LIUYIXIEYANG/CH32V307-Dual-brushless-motor-drive/PCB_Project(V1.1)/单车驱动BOM.xlsx

Comment | Designator | Footprint | Quantity
0.1uF | C1, C5, C6, C11, C12, C22, C25, C26, C27, C28, C32, C37, C39, C41, C52, C54, C56, C63, C68, C73, C78, C79, C80, C84, C85 | C0603_NS | 25
220uF/16V | C2, C3 | CT 2.5*6.3*7 - R | 2 | https://item.szlcsc.com/123510.html
10uF/25V | C4, C10, C20, C21, C24, C60 | C0603_NS | 6
22uF/25V | C7, C8, C13, C14, C15, C16 | C0805_NS | 6
NC | C9 | C0603_NS | 1
1uF | C17, C18, C19, C30 | C0603_NS | 4
22pF | C23, C29 | C0603_NS | 2
10nF | C31 | C0603_NS | 1
470nF | C33, C34, C35, C48, C49, C50 | C0603_NS | 6
10uF/25V | C36, C38, C40, C42, C43, C44, C45, C46, C47, C51, C53, C55, C57, C58, C59, C61, C62 | C0603_NS | 17
100pF | C64, C65, C69, C70, C74, C75 | C0603_NS | 6
1nF | C66, C67, C71, C72, C76, C77, C81, C82, C83, C86, C87, C88 | C0603_NS | 12
SMBJ18CA | D1 | SMB | 1 | https://item.szlcsc.com/84491.html
B5819W | D2 | SOD-123 | 1 | https://item.taobao.com/item.htm?spm=a1z10.3-c-s.w4002-24706531953.18.49736a4bXCLATq&id=578556528655
LED | D3, D4, D5 | LED0603_NS | 3
PESD1CAN | D6 | SOT23-3N | 1 | https://item.taobao.com/item.htm?spm=a1z10.3-c-s.w4002-24706531953.10.3d946a4bvhPwcH&id=581111679208
10A/32V | F1 | FU 1206 | 1 | 贴片熔断保险丝 1206 1A/2A/3/4/5/7/10A/15A/20A 32V/63/72/125V-淘宝网 (taobao.com) (https://item.taobao.com/item.htm?spm=a230r.1.14.3.70f112a8YnFDwl&id=574527944611&ns=1&abbucket=12) |  | 1206贴片熔断保险丝0.5A/1234A5A7A10A12A15A20A25A30A 24V32V63V-淘宝网 (taobao.com) (https://item.taobao.com/item.htm?spm=a230r.1.14.9.70f112a8YnFDwl&id=623390103028&ns=1&abbucket=12)
600Ω,500mA | FB1 | FB0603_NS | 1 | https://item.szlcsc.com/20038.html
SS-12D10L5 | K1 | SS-12D10 | 1 | https://item.szlcsc.com/300104.html
4.7uH | L1 | L-SMD-0630 | 1 | https://item.szlcsc.com/397799.html
MSD7342-223 | L2 | MSD7342 | 1 | https://item.taobao.com/item.htm?spm=a1z10.3-c-s.w4002-24391130176.33.72fbd7598o98C6&id=644408858473 |  |  | 22UH
HDR-1X3 | P1, P6 | HDR2.54-WI-3P | 2 | https://item.taobao.com/item.htm?spm=a1z10.5-c-s.w4002-24706531925.45.1a03173e28t522&id=570974088458
GH1.25-4P | P2 | A1257WR-S-4P | 1 | https://item.szlcsc.com/225410.html | https://item.taobao.com/item.htm?spm=a1z0d.6639537/tb.1997196601.232.55f97484m3fdcZ&id=622151561707
GH1.25-2P | P3 | A1257WR-S-2P | 1 | https://item.szlcsc.com/225408.html | GH1.25 2P/3/4/5/6-12P 15C单/双头1.25mm间距电子线带锁扣端子线-淘宝网 (taobao.com) (https://item.taobao.com/item.htm?spm=a1z0d.6639537/tb.1997196601.144.55f97484m3fdcZ&id=620275448420)
GH1.25-6P | P4, P5 | A1257WR-S-6P | 2 | https://item.szlcsc.com/225412.html
VS3508AE | Q1, Q2 | PowerPAK1212-8 | 2 | https://item.szlcsc.com/423219.html
AON7934 | Q3, Q4, Q5, Q6, Q7, Q8 | POWERPAIR_3X3 | 6 | https://item.szlcsc.com/494116.html
10K | R1, R13, R14 | R0603_NS | 3
100K | R2, R5 | R0603_NS | 2
100K/1% | R3, R52, R60 | R0603_NS | 3
11K/1% | R4 | R0603_NS | 1
1K | R6, R15, R16, R17 | R0603_NS | 4
10.5K/1% | R7 | R0603_NS | 1
2K/1% | R8 | R0603_NS | 1
100R | R9, R18, R19, R20, R21, R22, R23, R33, R34, R35, R36, R37, R38, R39, R49, R56, R57, R70, R71, R84, R85, R93, R94, R98, R99, R100, R104, R105, R106, R107 | R0603_NS | 30
4.12K/1% | R10 | R0603_NS | 1
12.4K/1% | R11 | R0603_NS | 1
1M | R12 | R0603_NS | 1
4R7 | R24, R25, R26, R27, R28, R29, R40, R41, R42, R43, R44, R45 | R0603_NS | 12
5mΩ/1% | R30, R31, R32, R46, R47, R48 | R1206_NS | 6 | https://item.szlcsc.com/470067.html
1K/1% | R50, R51, R58, R59 | R0603_NS | 4
1K/0.1% | R53, R54, R61, R62, R64, R65, R67, R68, R72, R73, R75, R76, R78, R79, R81, R82, R86, R87, R89, R90 | R0603_NS | 20
100K/0.1% | R55, R63, R66, R69, R74, R77, R80, R83, R88, R91 | R0603_NS | 10
120R | R92 | R0603_NS | 1
4.7K | R95, R96, R97, R101, R102, R103 | R0603_NS | 6
TS-1101-C-R | S1, S2 | TS-1101 | 2 | https://item.taobao.com/item.htm?spm=a1z10.5-c-s.w4002-24706531925.44.170040e6u5CuXK&id=556985020016
SY8105IADC | U1 | SOT23-6N | 1 | https://item.szlcsc.com/3408748.html
JW5026 | U2 | SOT23-6N | 1 | https://item.taobao.com/item.htm?id=680449503459&ns=1&abbucket=12 (https://item.taobao.com/item.htm?spm=a230r.1.14.3.2a21407aBVZD0H&id=680449503459&ns=1&abbucket=12)
RT9193 | U3 | SOT23-5N | 1 | https://item.taobao.com/item.htm?spm=a1z10.3-c-s.w4002-24706531953.10.63116a4bdsNMNh&id=522574021262
TLV431A | U4 | SOT23-3N | 1 | https://item.szlcsc.com/92264.html
CH32V307RCT6 | U5 | LQFP64_N | 1 | https://item.szlcsc.com/3443981.html
DGD05473FN-7 | U6, U7, U8, U9, U10, U11 | W-DFN3030-10_DGD05473 | 6 | https://item.szlcsc.com/203239.html
RS8552XM | U12, U13, U14 | TSSOP8_N | 3 | https://item.szlcsc.com/236482.html
TJA1050 | U15 | SOP8_N | 1 | https://item.taobao.com/item.htm?spm=a1z10.3-c-s.w4002-24706531953.9.284e6a4bbopgaC&id=522573702724
8MHz | Y1 | SMD-3225-4P | 1 | https://item.taobao.com/item.htm?spm=a1z10.3-c-s.w4002-24706531953.10.33e26a4bPSt3Qt&id=624959605211
