LIUYIXIEYANG/CH32V307-Dual-brushless-motor-drive/PCB_Project(V1.1)/单车驱动_SCH.pdf

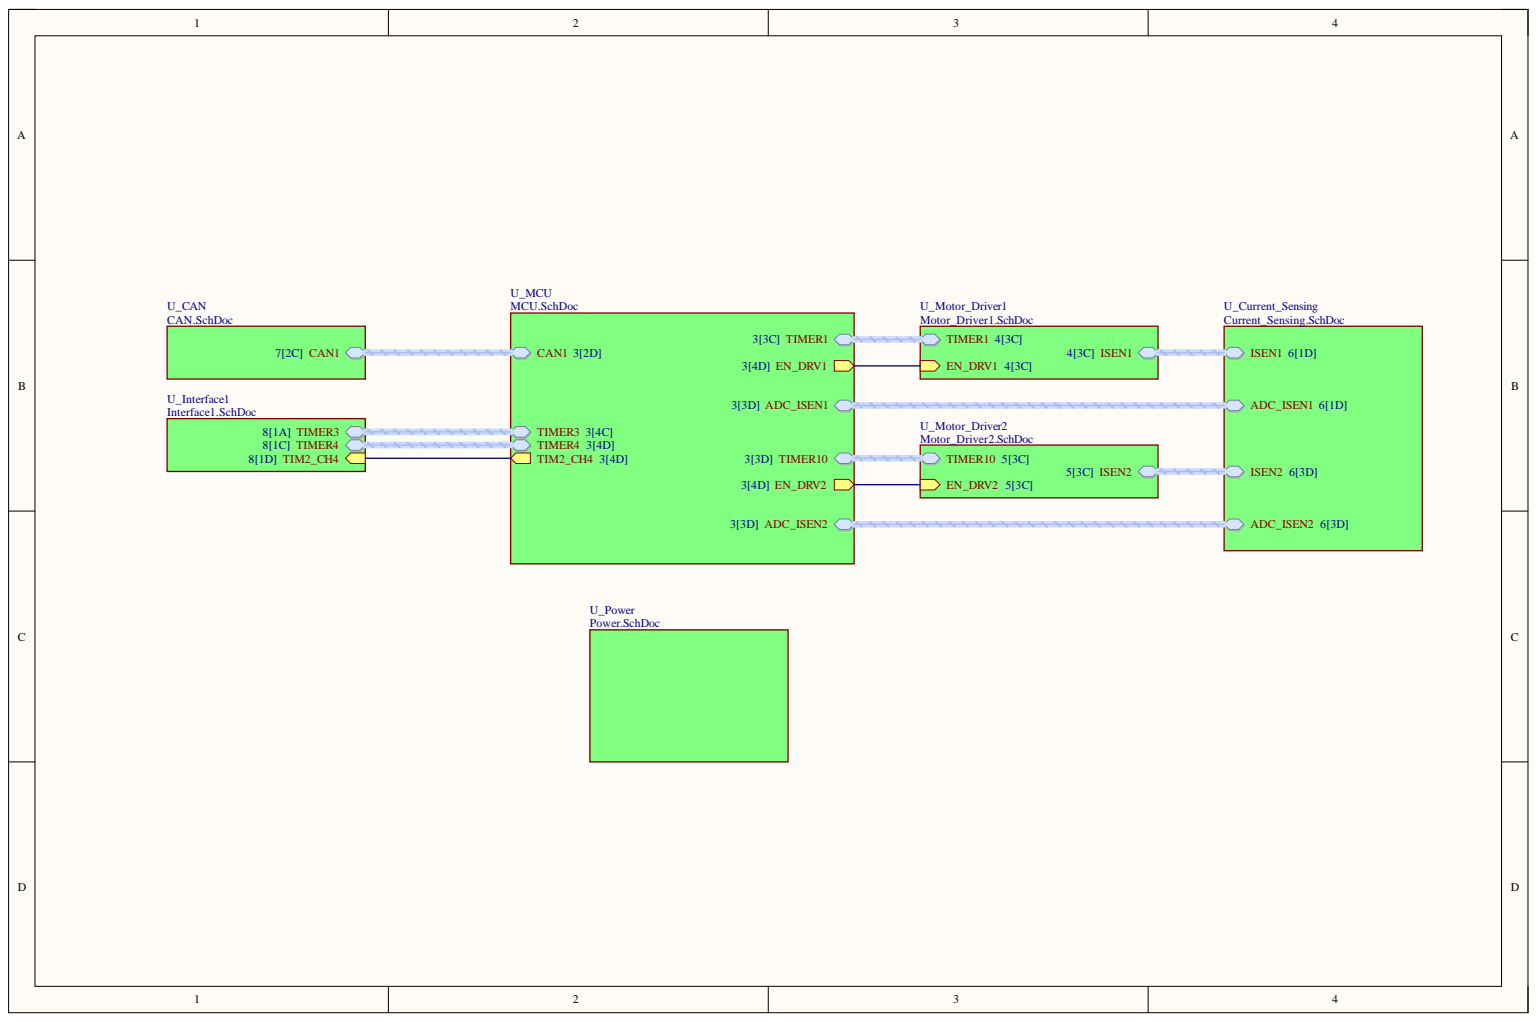
[picture p1: page 1]

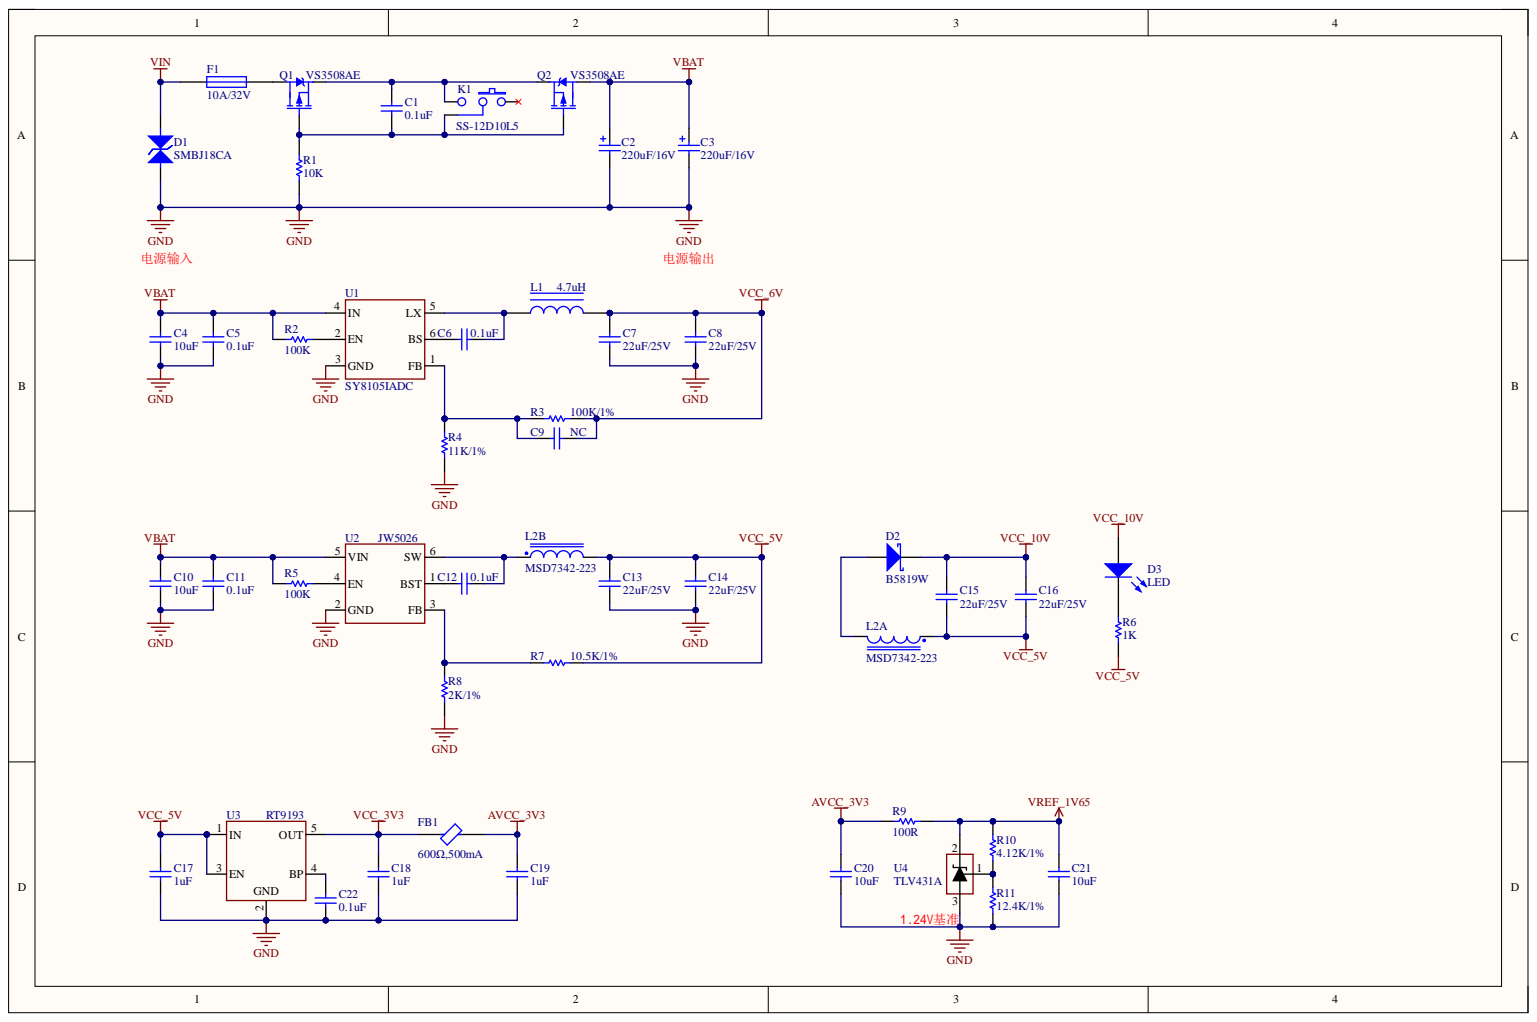
[picture p2: page 2]

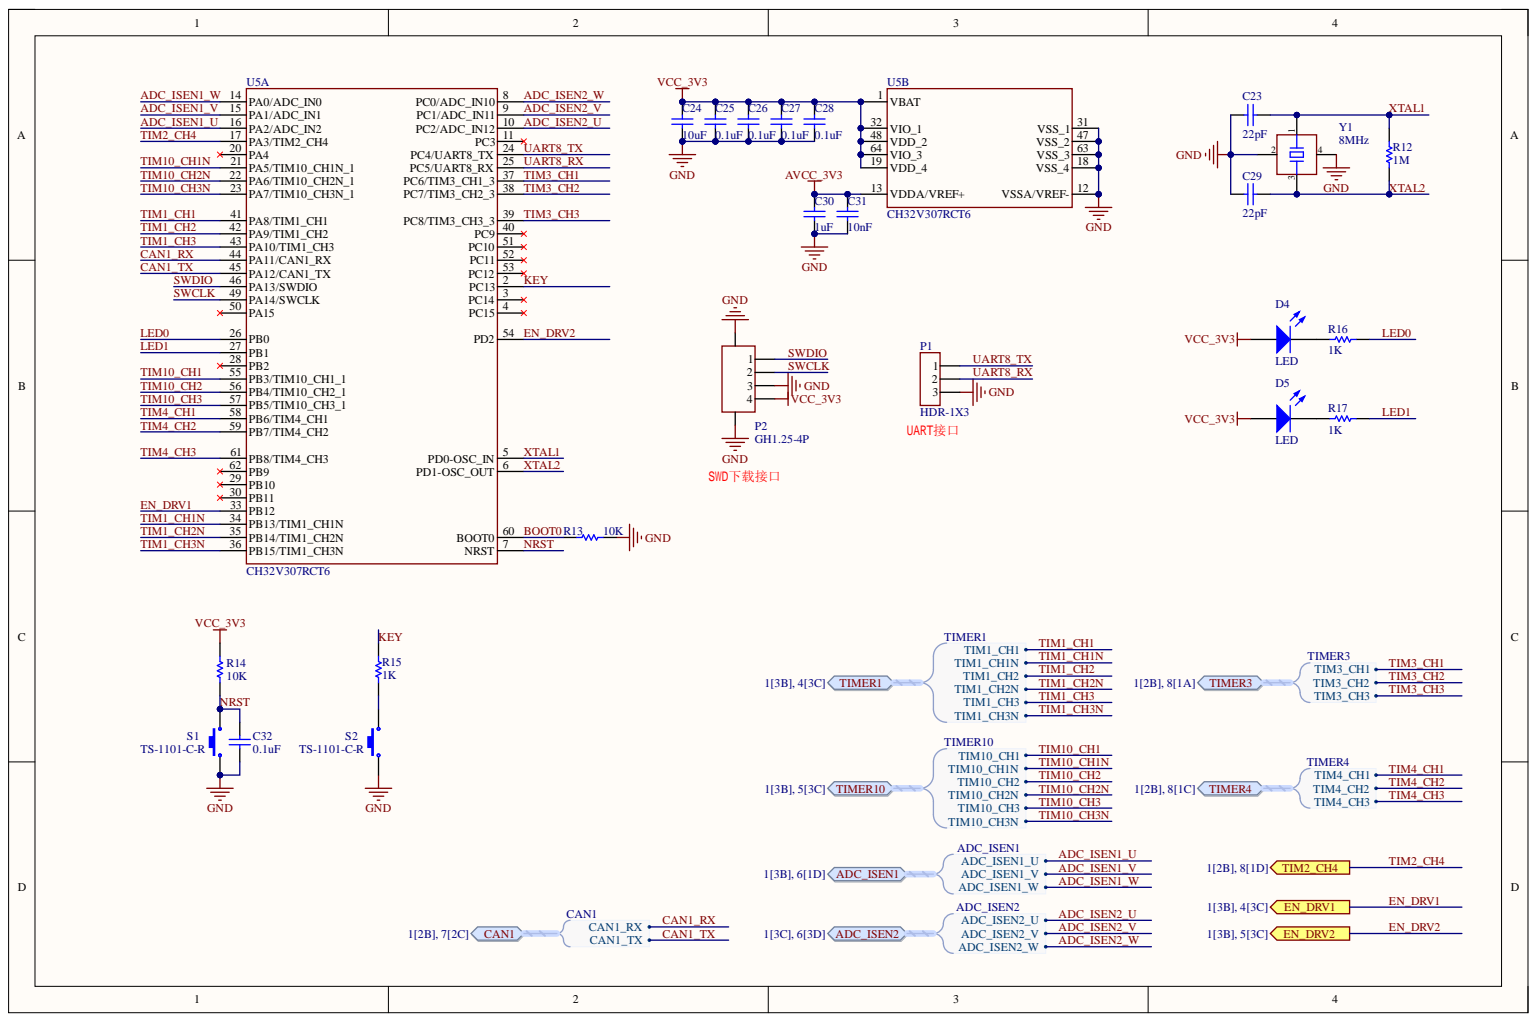
[picture p3: page 3]

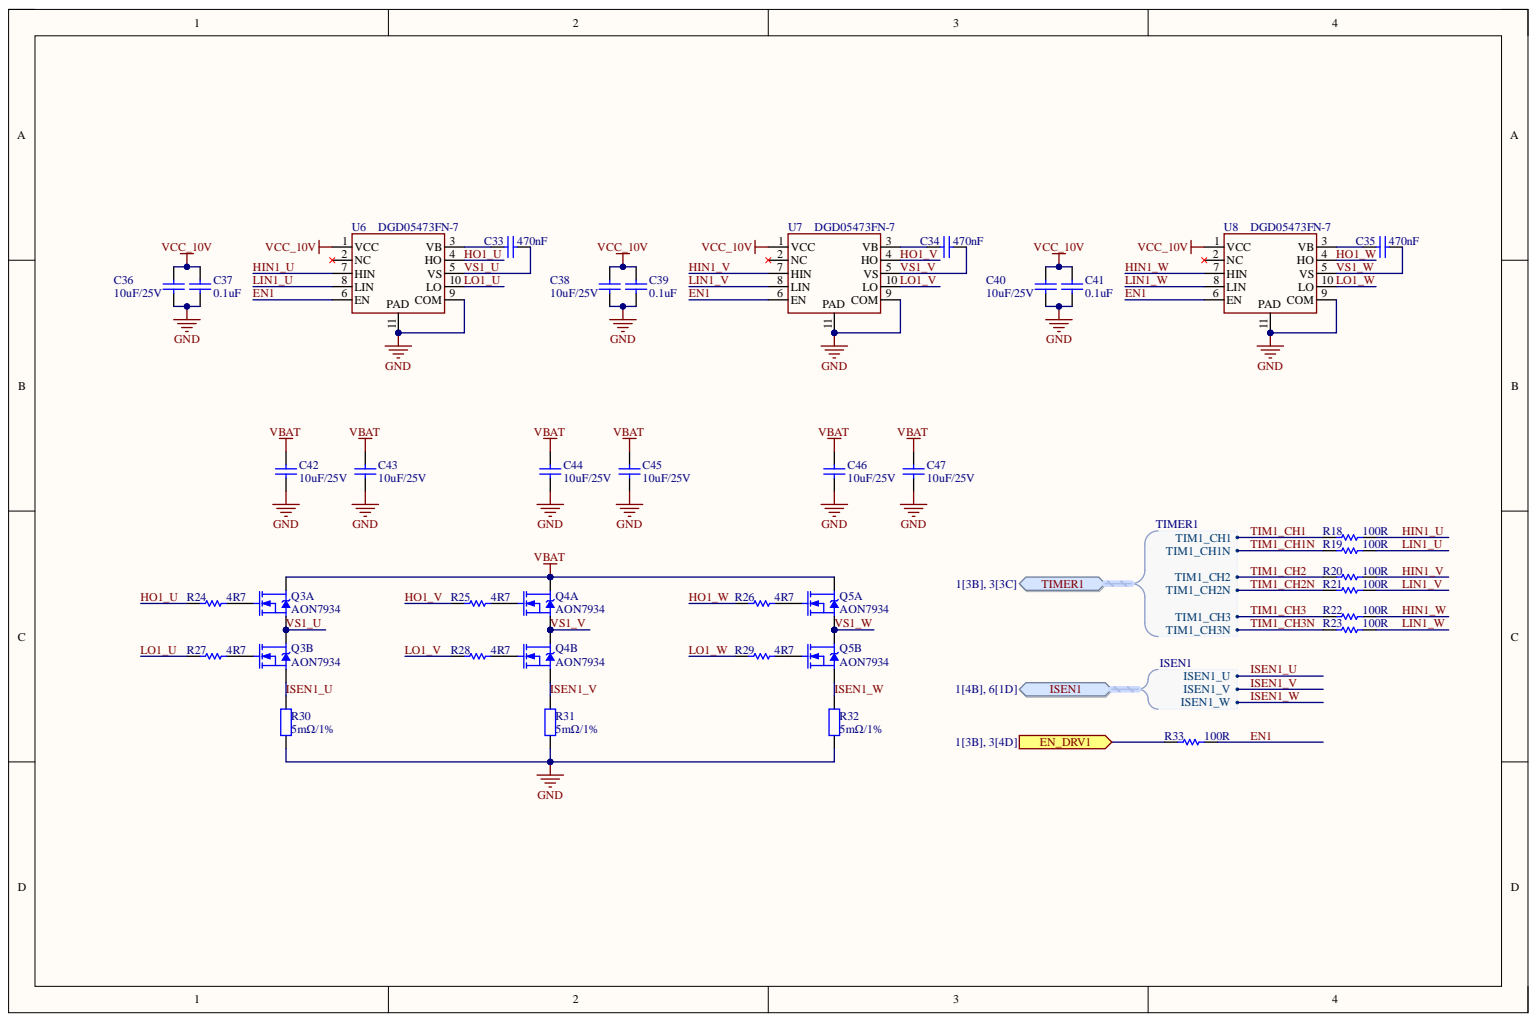
[picture p4: page 4]

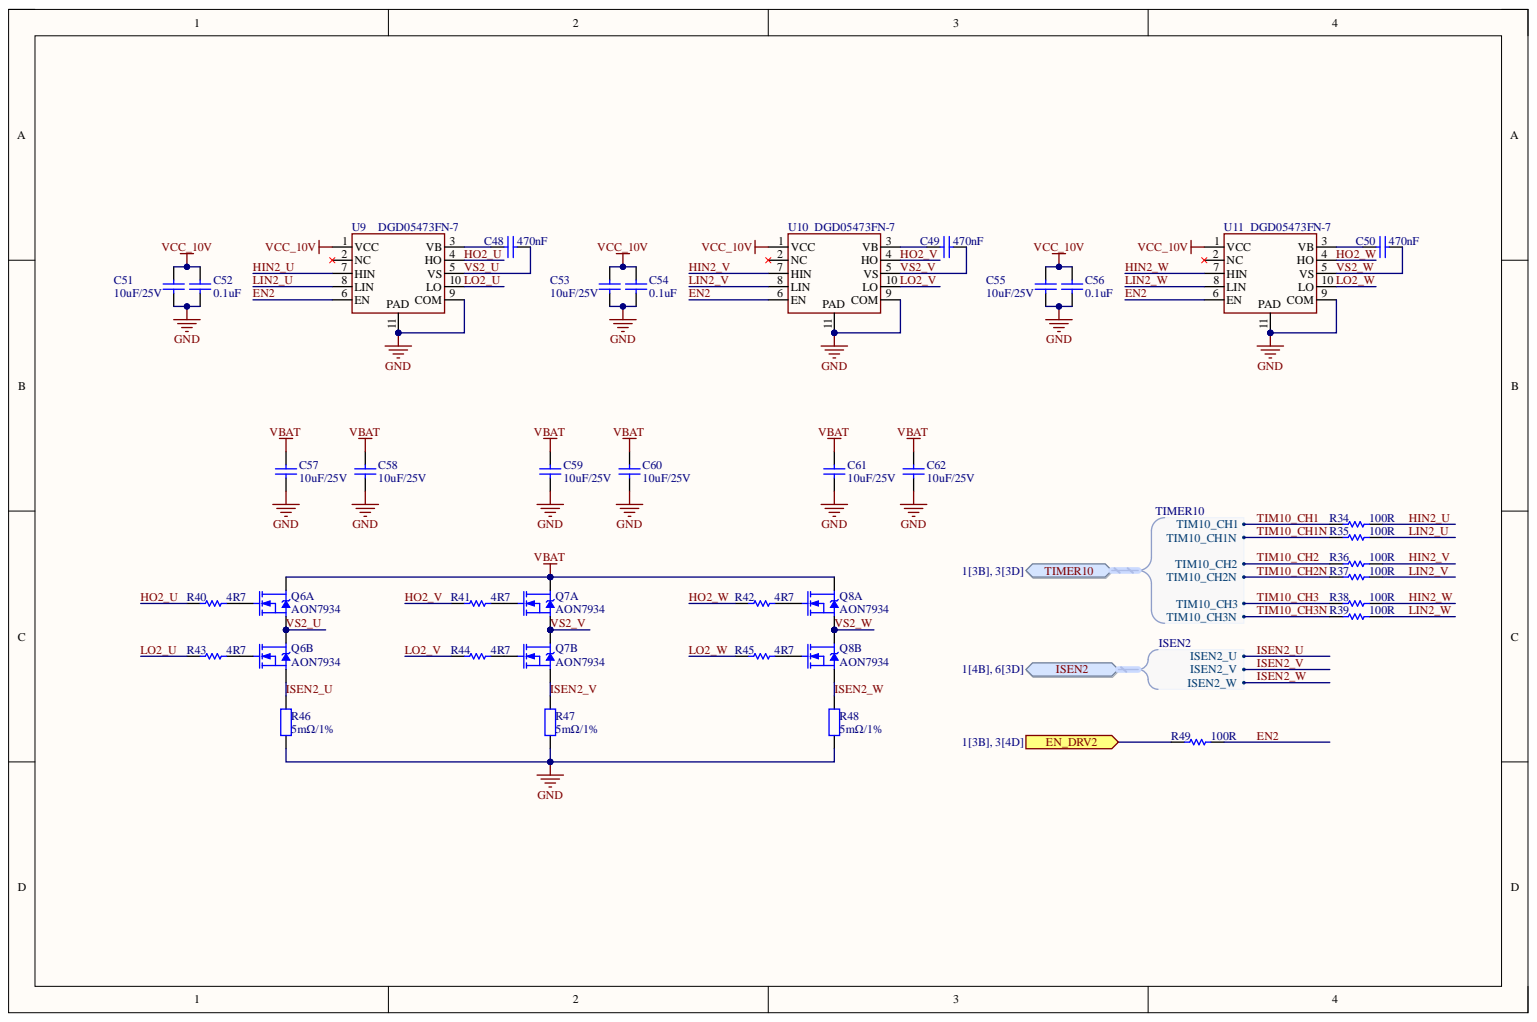
[picture p5: page 5]

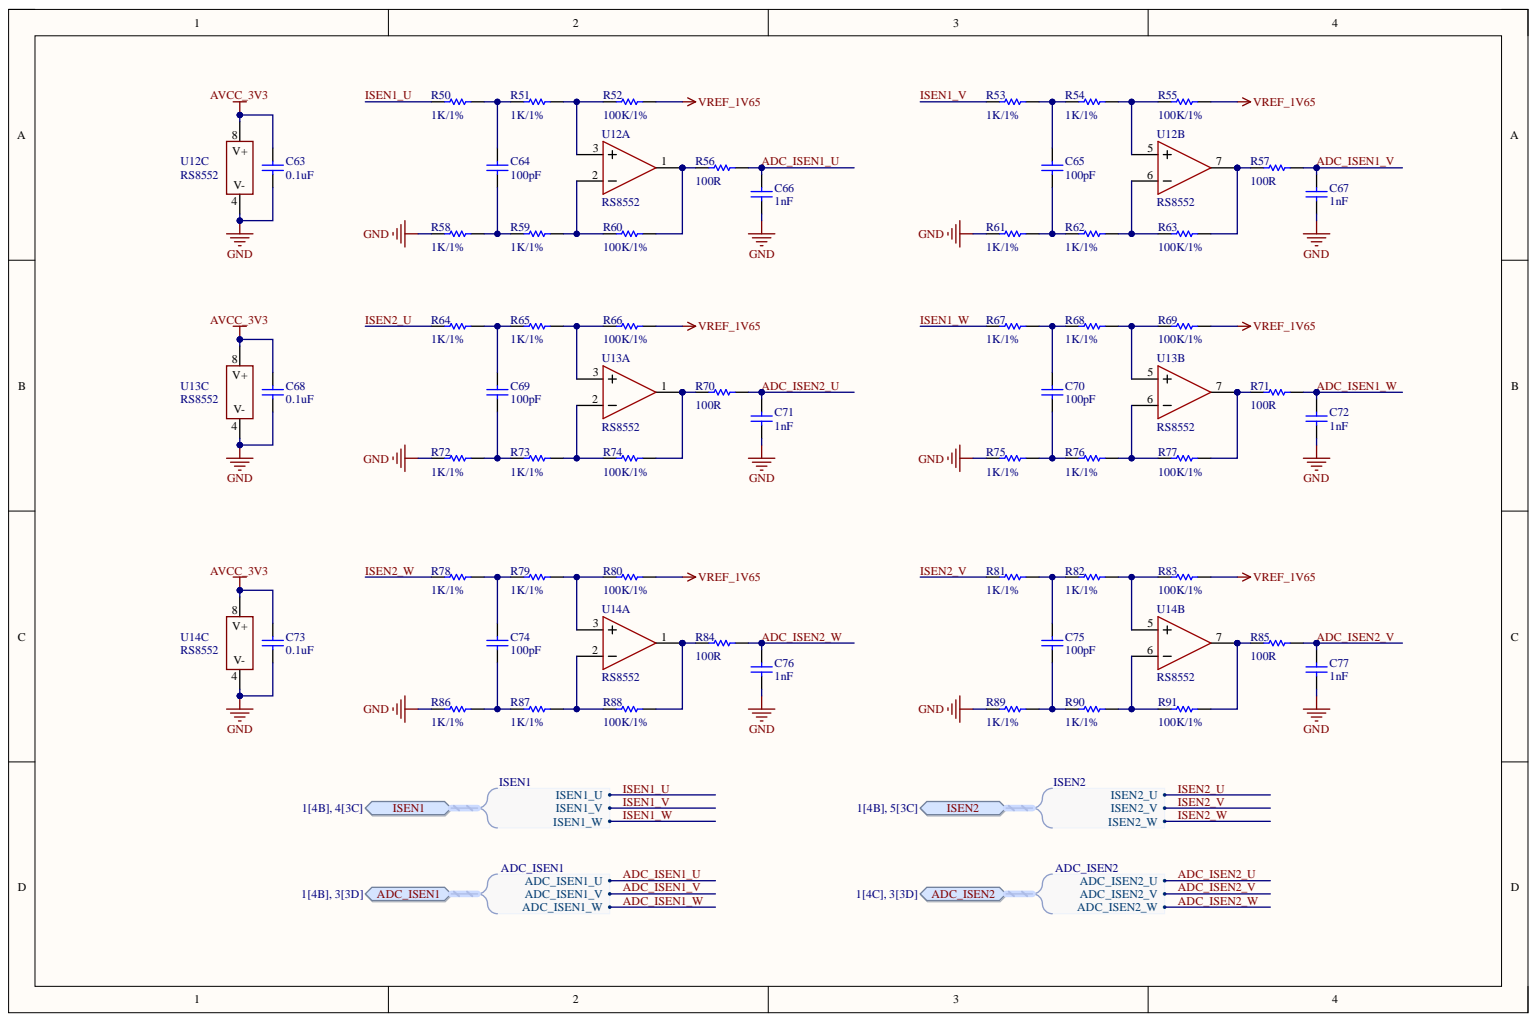
[picture p6: page 6]

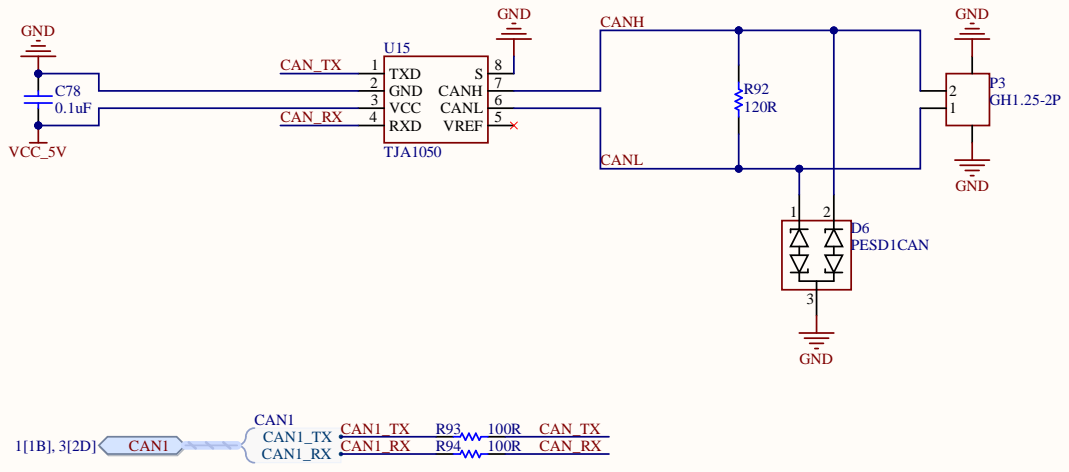
[picture p7: page 7]

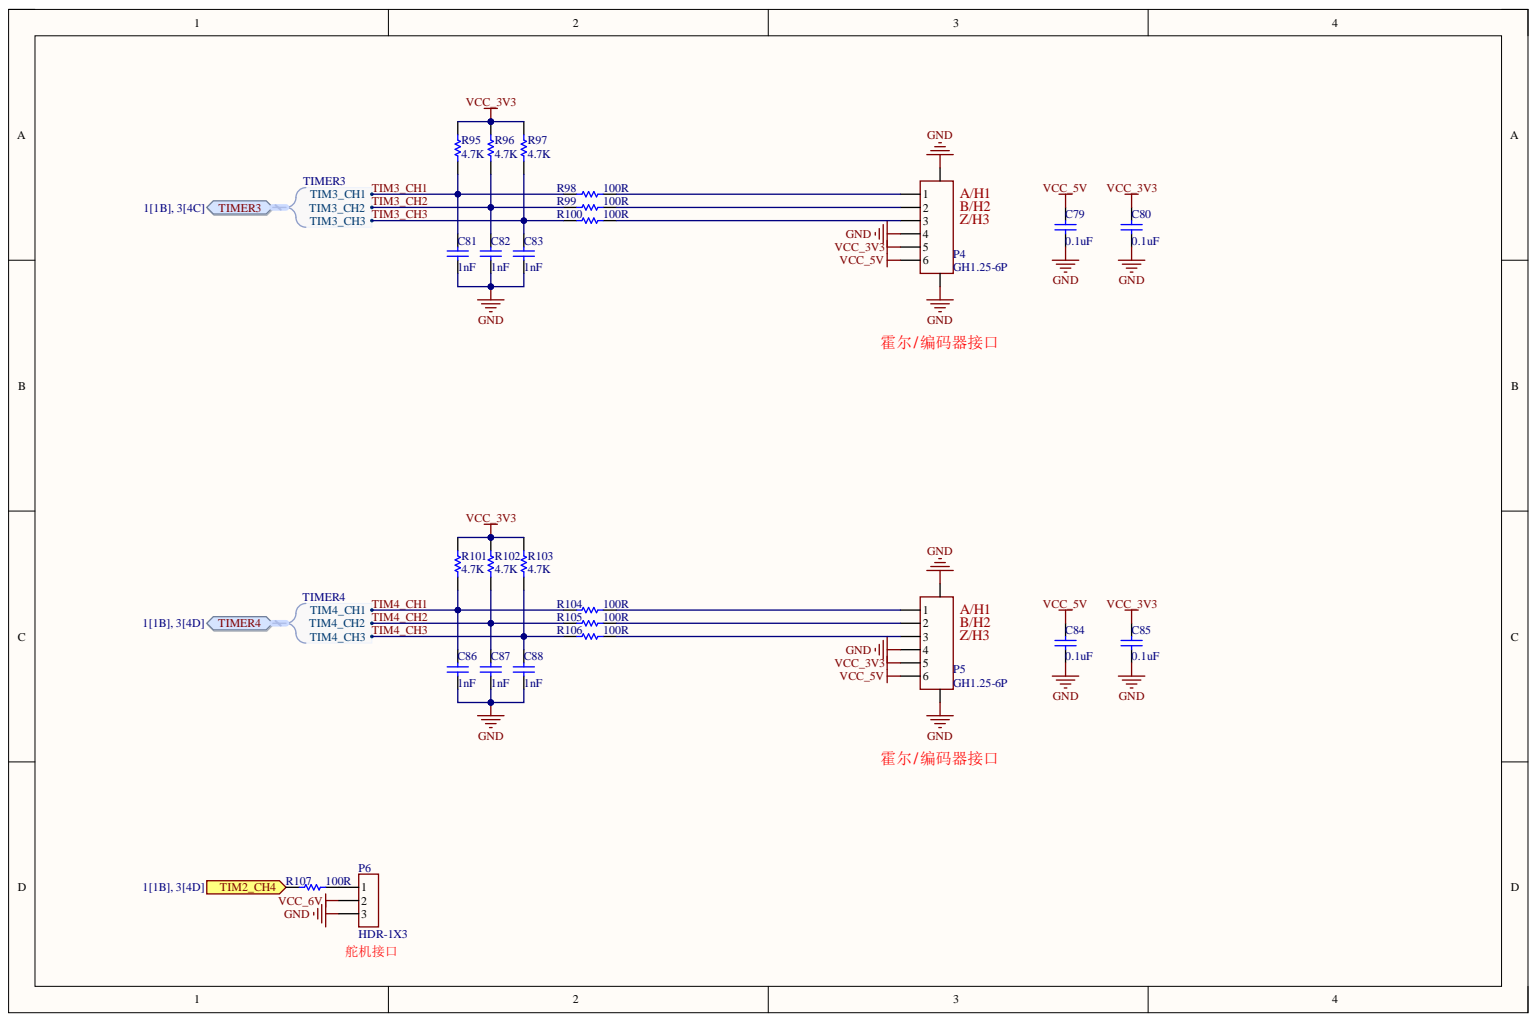
[picture p8: page 8]
