LIUYIXIEYANG/CH32V307-Dual-brushless-motor-drive/PCB_Project/PCB1.pdf

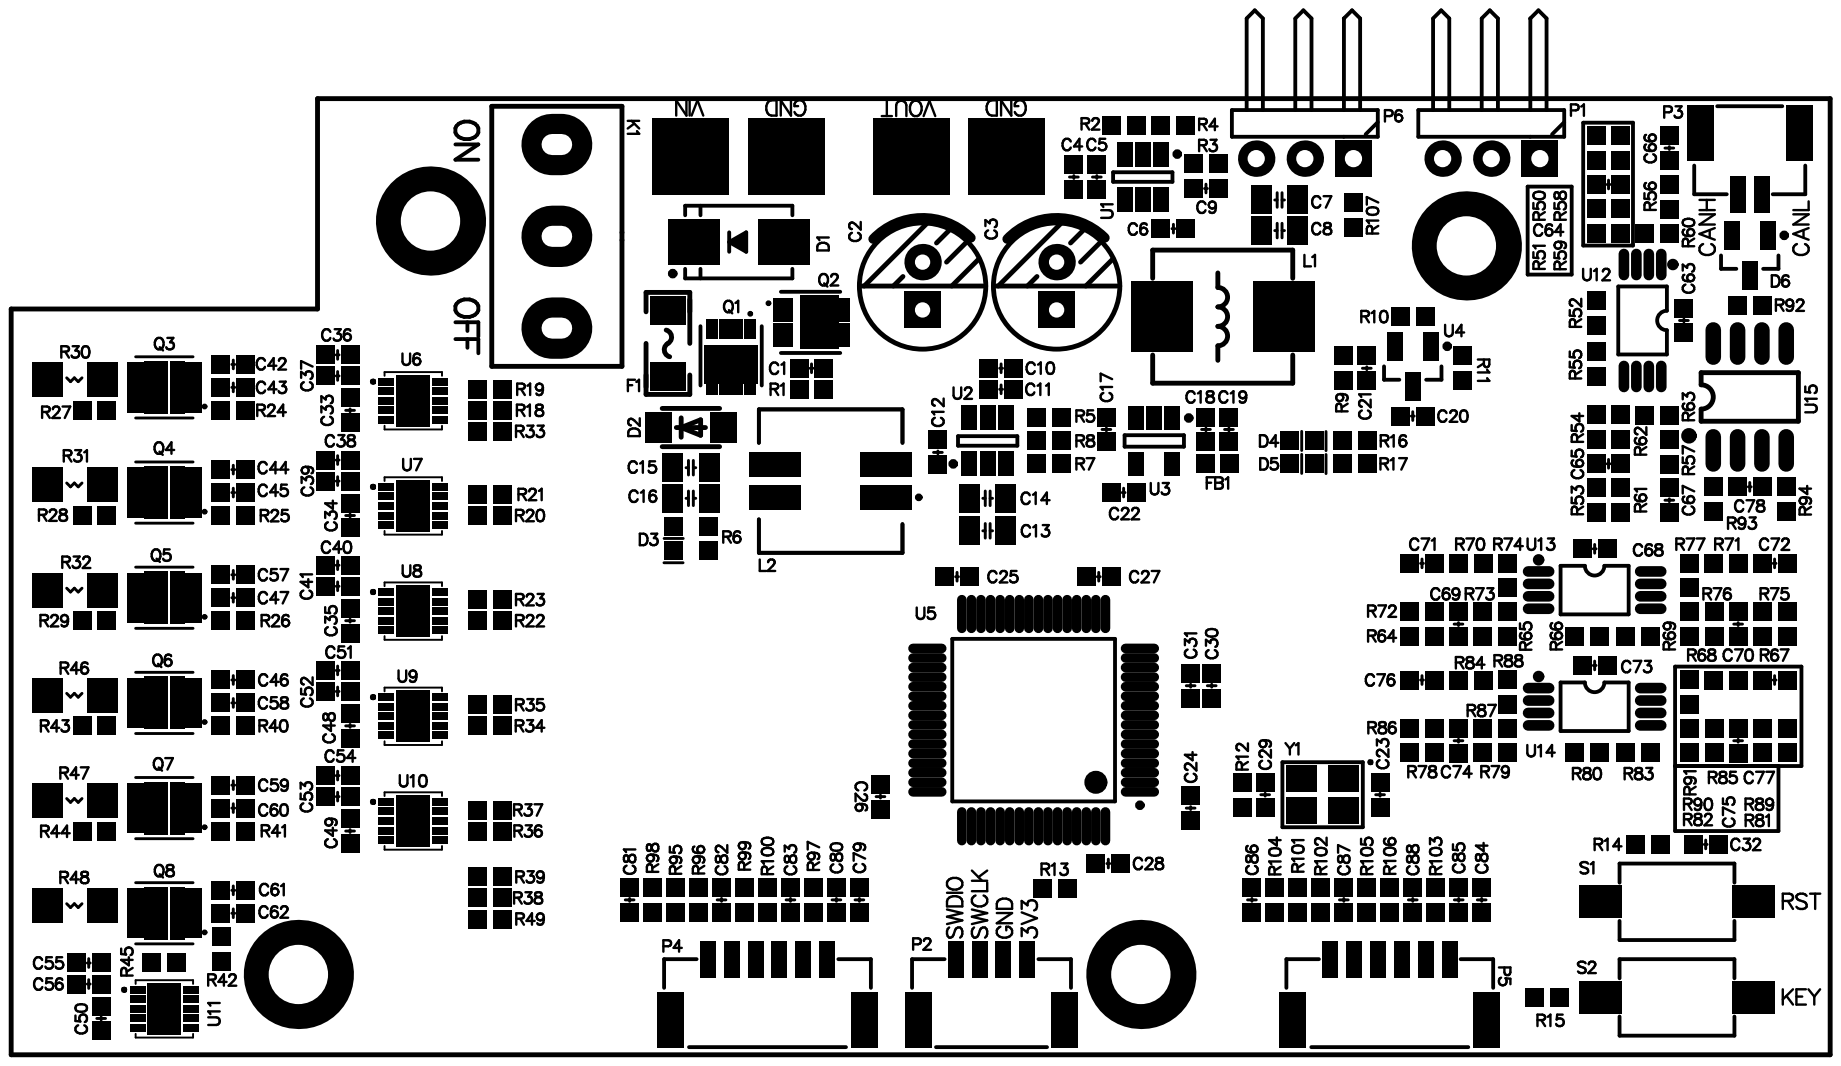
[picture p9: page 1]

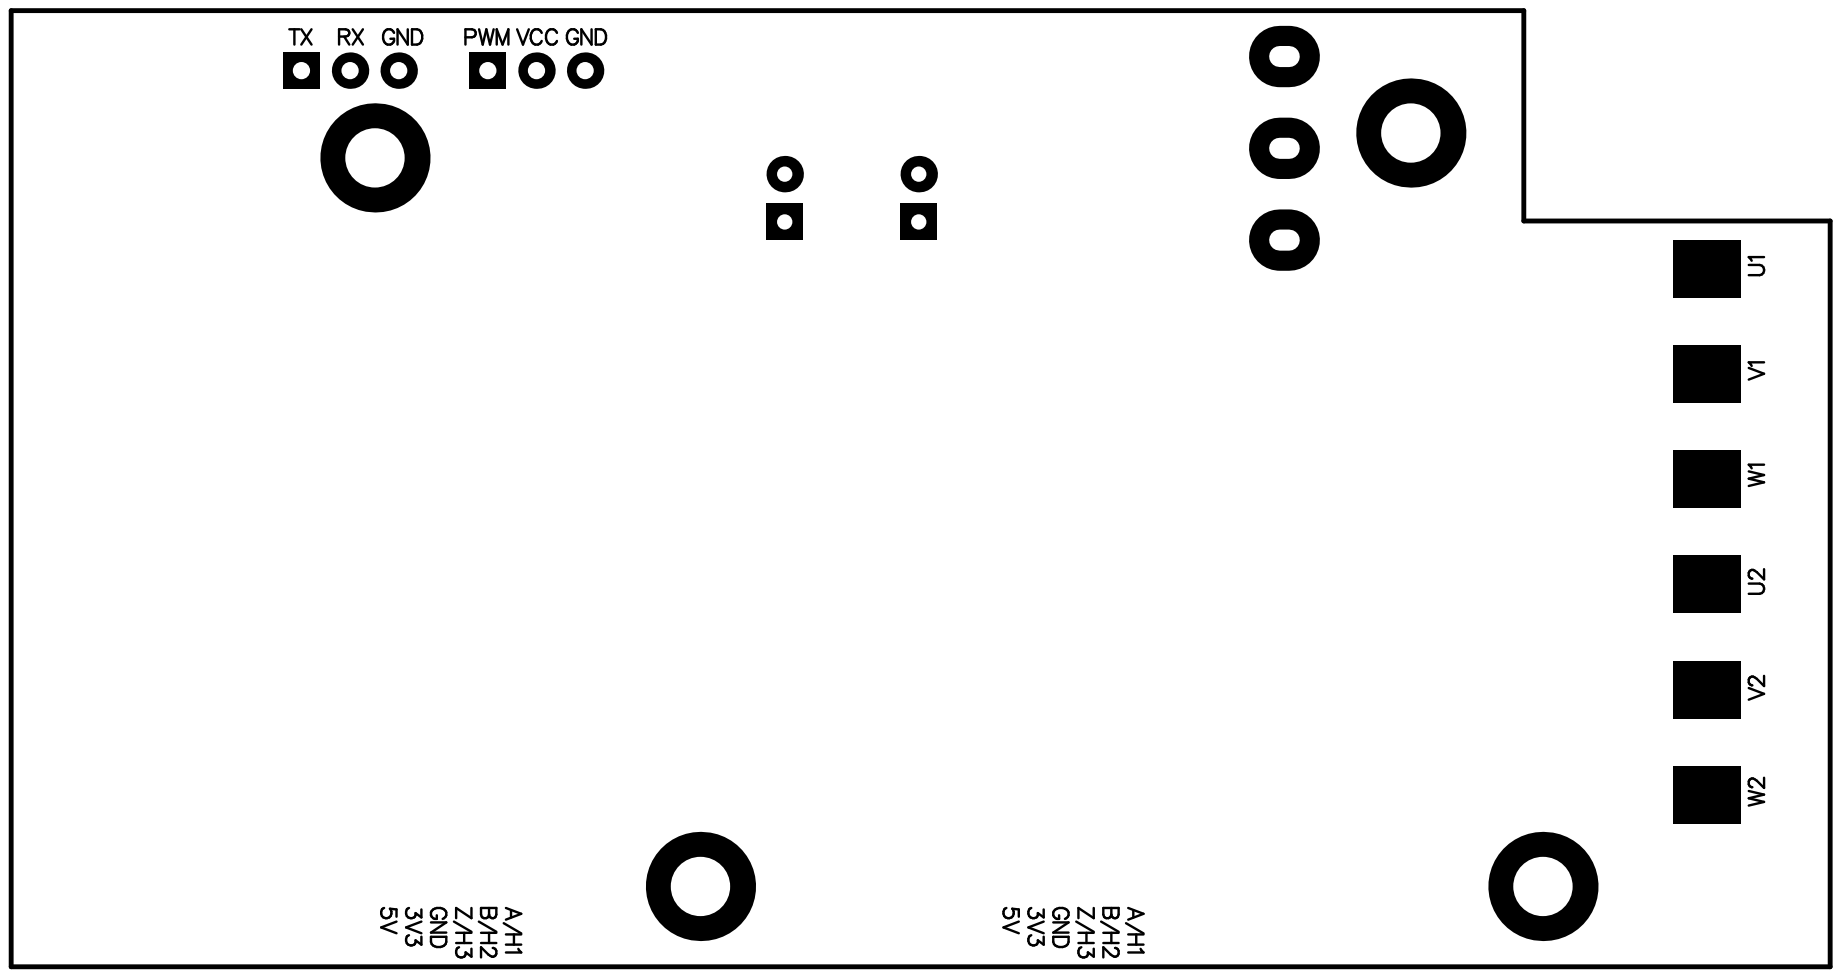
[picture p10: page 2]
