LIUYIXIEYANG/CH32V307-Dual-brushless-motor-drive/(list of files, drawings)

Other design files:
PCB_Project(V1.1)/CAN.SchDoc
PCB_Project(V1.1)/Current_Sensing.SchDoc
PCB_Project(V1.1)/Interface1.SchDoc
PCB_Project(V1.1)/Interface2.SchDoc
PCB_Project(V1.1)/MCU.SchDoc
PCB_Project(V1.1)/Motor_Driver1.SchDoc
PCB_Project(V1.1)/Motor_Driver2.SchDoc
PCB_Project(V1.1)/Power.SchDoc
PCB_Project(V1.1)/Top_Level.SchDoc
PCB_Project(V1.1)/单车驱动.PrjPcb
